gallicchio/op-amp-pcb/design_reviews/2026-10-24_Claude-Fable-5.1/z_sw1.png

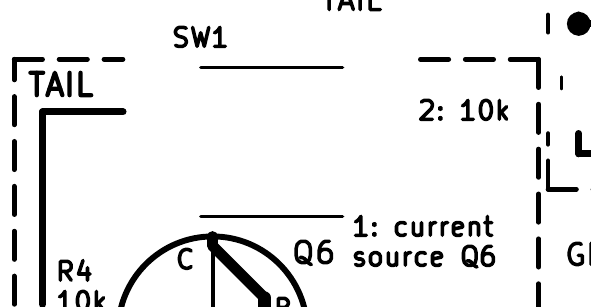
design_reviews/2026-10-24_Claude-Fable-5.1/z_sw1.png
