gallicchio/op-amp-pcb/design_reviews/2026-10-27_KimiK3/bcu-1.png

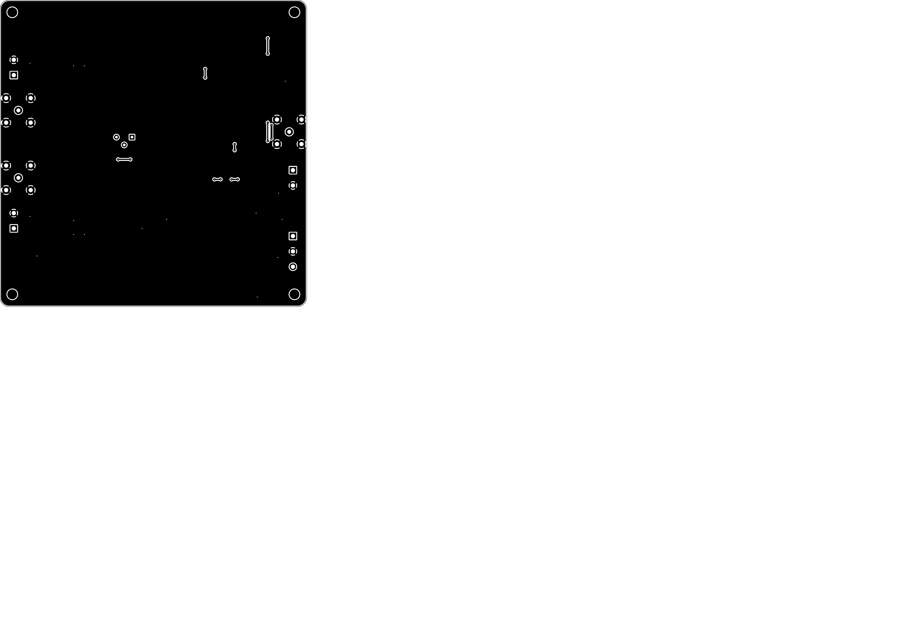
design_reviews/2026-10-27_KimiK3/bcu-1.png
