gallicchio/op-amp-pcb/design_reviews/2026-10-27_KimiK3/crop_d1d2.png

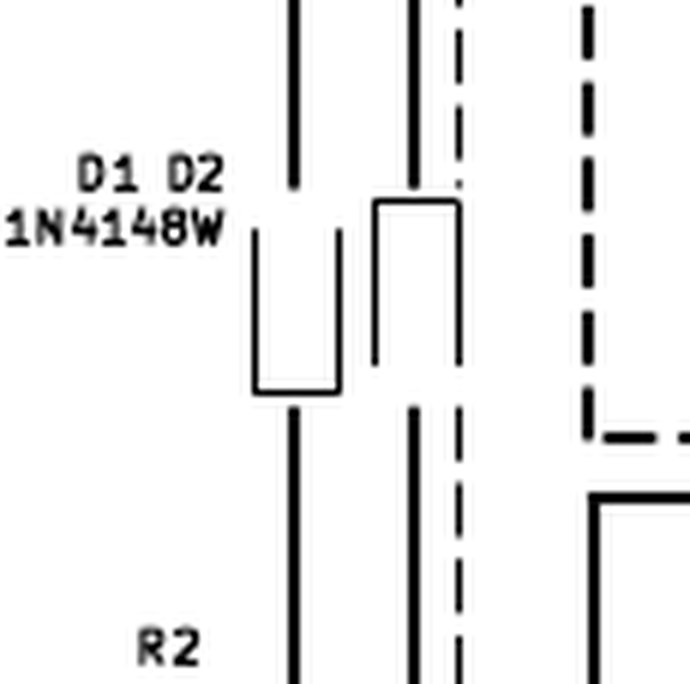
design_reviews/2026-10-27_KimiK3/crop_d1d2.png
