gallicchio/op-amp-pcb/design_reviews/2026-10-27_KimiK3/crop_d5d6.png

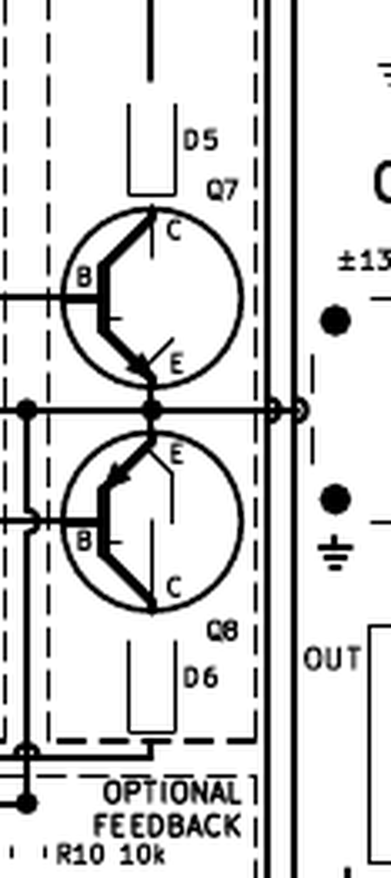
design_reviews/2026-10-27_KimiK3/crop_d5d6.png
