gallicchio/op-amp-pcb/design_reviews/2026-10-27_KimiK3/z_d5d6_big.png

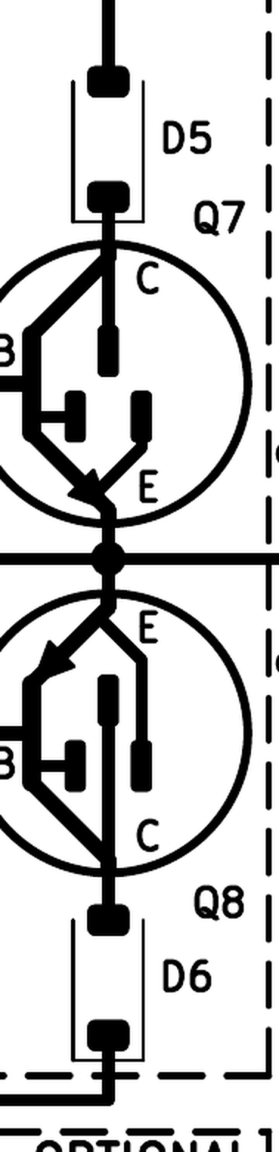
design_reviews/2026-10-27_KimiK3/z_d5d6_big.png
