gallicchio/op-amp-pcb/design_reviews/2026-10-27_KimiK3/z_gain_comp.png

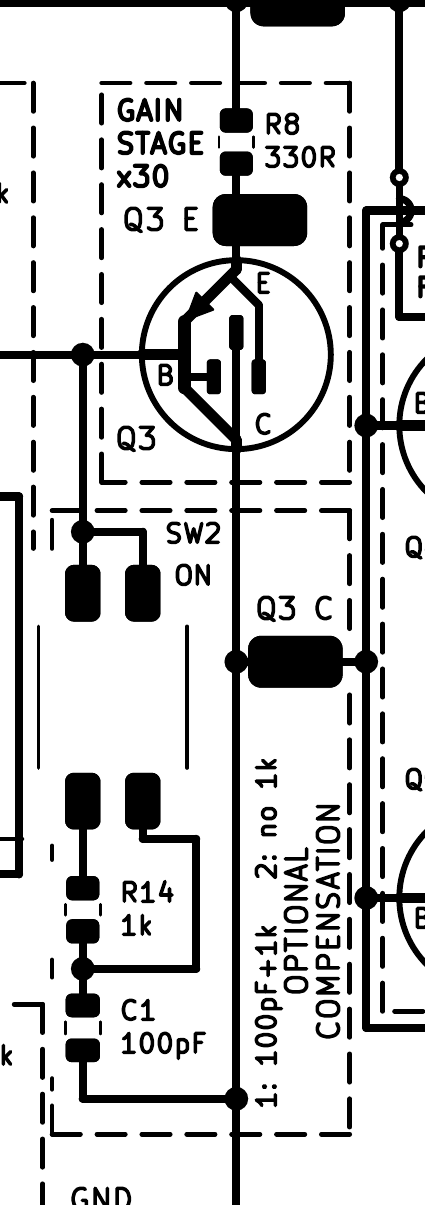
design_reviews/2026-10-27_KimiK3/z_gain_comp.png
