gallicchio/op-amp-pcb/docs/images/opamp-bottom.png

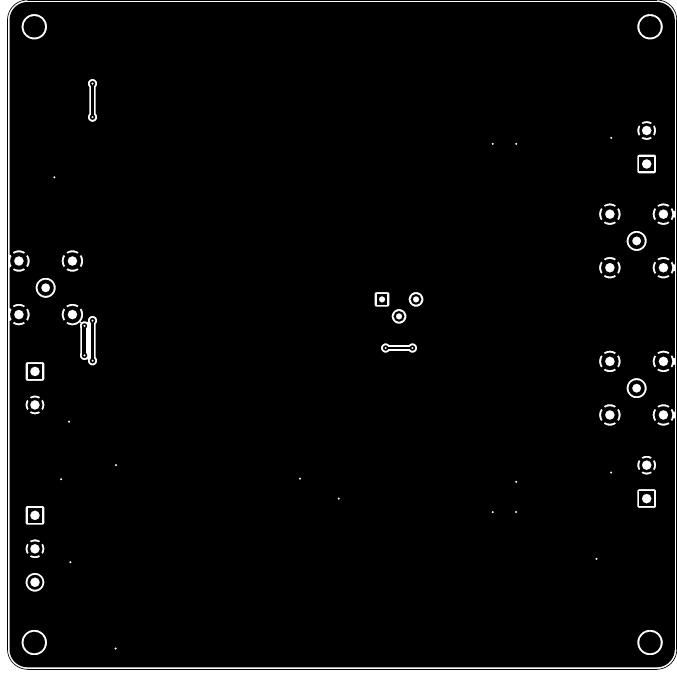
docs/images/opamp-bottom.png
