gallicchio/op-amp-pcb/docs/images/opamp-render-bottom.png

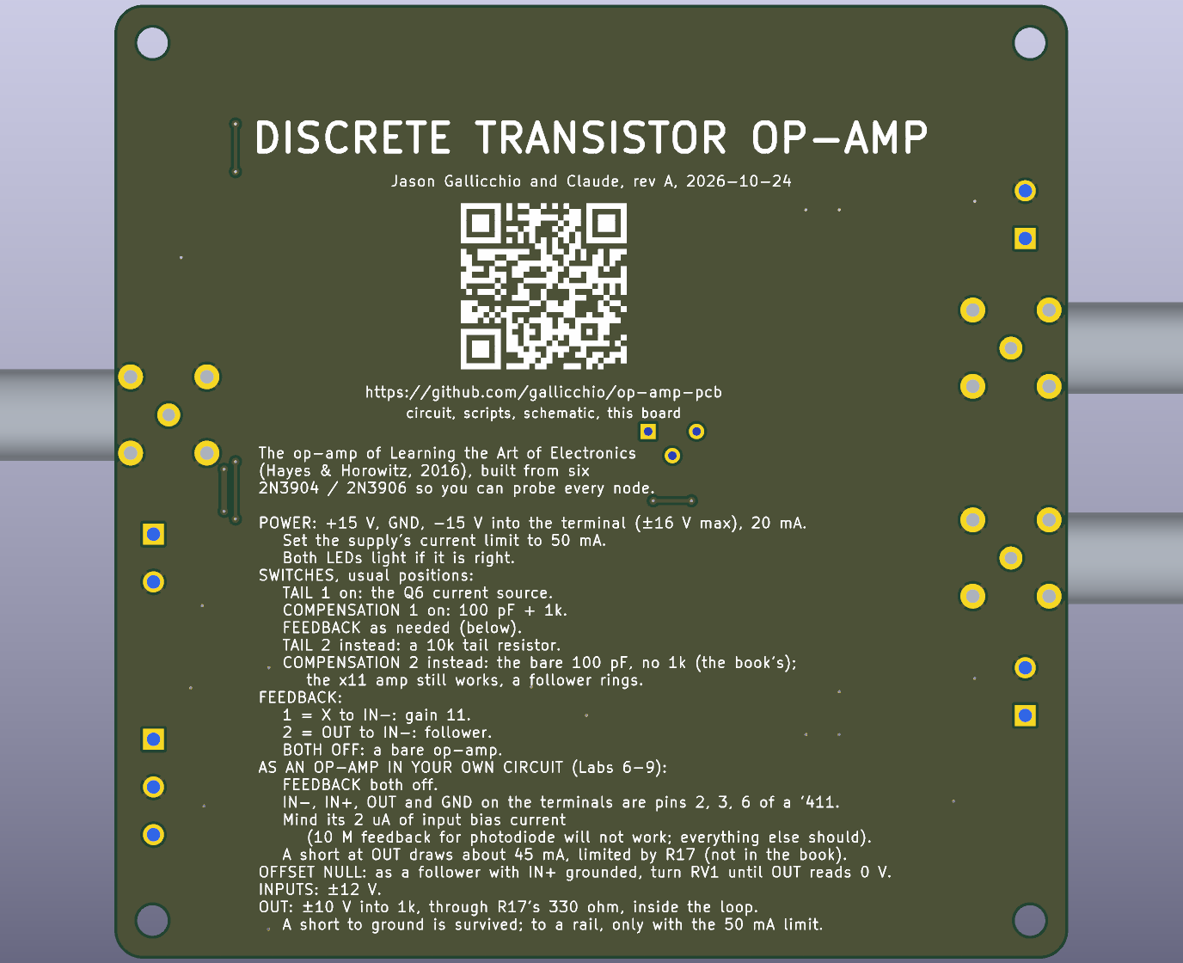
docs/images/opamp-render-bottom.png
