gallicchio/op-amp-pcb/docs/images/opamp-render-top.png

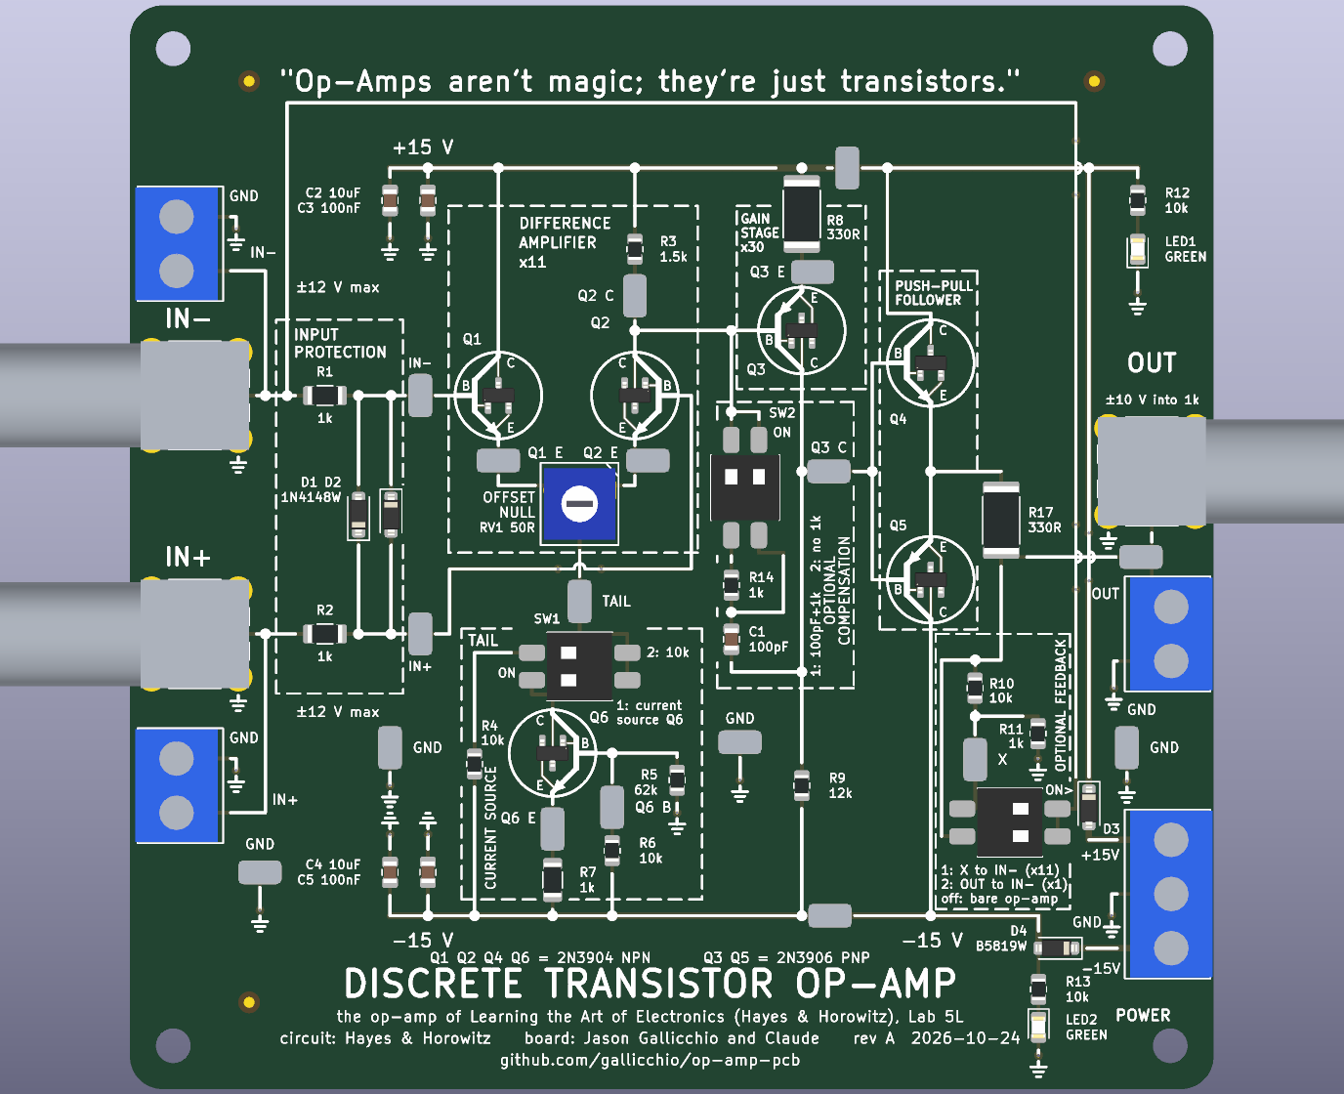
docs/images/opamp-render-top.png
