gallicchio/op-amp-pcb/docs/images/opamp-silk-top.png

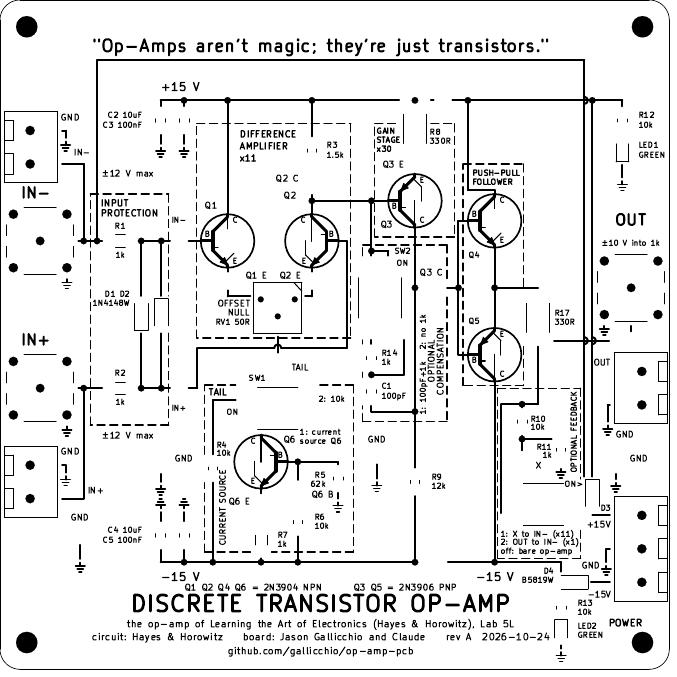
docs/images/opamp-silk-top.png
