gallicchio/op-amp-pcb/out/opamp/opamp_bom_costed.csv

Comment | Designator | Footprint | LCSC Part # | MPN | Qty | Unit $ | Ext $ | JLC
100pF | C1 | C_0805_2012Metric | C1790 | CL21C101JBANNNC | 1 | 0.0101 | 0.010 | basic
10uF | C2,C4 | C_0805_2012Metric | C15850 | CL21A106KAYNNNE | 2 | 0.0426 | 0.085 | basic
100nF | C3,C5 | C_0805_2012Metric | C49678 | CC0805KRX7R9BB104 | 2 | 0.0205 | 0.041 | basic
1N4148W | D1,D2 | D_SOD-123 | C81598 | 1N4148W | 2 | 0.0124 | 0.025 | basic
B5819W | D3,D4 | D_SOD-123 | C8598 | B5819W SL | 2 | 0.0260 | 0.052 | basic
IN- / GND | J4 | TerminalBlock_KF301_1x02_P5.00mm | C474881 | KF301-5.0-2P | 1 | 0.1020 | 0.102 | extended
IN+ / GND | J5 | TerminalBlock_KF301_1x02_P5.00mm | C474881 | KF301-5.0-2P | 1 | 0.1020 | 0.102 | extended
+15 / GND / -15 | J6 | TerminalBlock_KF301_1x03_P5.00mm | C474882 | KF301-5.0-3P | 1 | 0.1400 | 0.140 | extended
OUT / GND | J7 | TerminalBlock_KF301_1x02_P5.00mm | C474881 | KF301-5.0-2P | 1 | 0.1020 | 0.102 | extended
BNC | J1,J2,J3 | BNC_KYWE_RightAngle | C41416668 | BNC-KYWE-295-W4-N | 3 | 1.2930 | 3.879 | extended
GREEN | LED1,LED2 | LED_0805_2012Metric | C2297 | KT-0805G | 2 | 0.0164 | 0.033 | basic
2N3906 | Q3,Q5 | SOT-23 | C53444 | MMBT3906LT1G | 2 | 0.0190 | 0.038 | extended
2N3904 | Q1,Q2,Q4,Q6 | SOT-23 | C20526 | MMBT3904 | 4 | 0.0116 | 0.046 | basic
1.5k | R3 | R_0805_2012Metric | C4310 | 0805W8F1501T5E | 1 | 0.0028 | 0.003 | basic
62k | R5 | R_0805_2012Metric | C17783 | 0805W8F6202T5E | 1 | 0.0021 | 0.002 | preferred
12k | R9 | R_0805_2012Metric | C17444 | 0805W8F1202T5E | 1 | 0.0028 | 0.003 | basic
50R | RV1 | Potentiometer_Bourns_3362P_Vertical | C52754333 | 3362P-1-500 | 1 | 0.3370 | 0.337 | extended
330R | R8,R17 | R_2512_6332Metric | C2934068 | FRC2512F3300TS | 2 | 0.0348 | 0.070 | extended
1k | R11,R14 | R_0805_2012Metric | C17513 | 0805W8F1001T5E | 2 | 0.0035 | 0.007 | basic
1k | R1,R2,R7 | R_1206_3216Metric | C4410 | 1206W4F1001T5E | 3 | 0.0085 | 0.026 | basic
10k | R4,R6,R10,R12,R13 | R_0805_2012Metric | C17414 | 0805W8F1002T5E | 5 | 0.0034 | 0.017 | basic
TAIL | SW1 | SW_DIP_SPSTx02_KingTek_DSIC02_P2.54mm | C54949 | DSIC02LSGET | 1 | 0.3080 | 0.308 | extended
COMPENSATION | SW2 | SW_DIP_SPSTx02_KingTek_DSIC02_P2.54mm | C54949 | DSIC02LSGET | 1 | 0.3080 | 0.308 | extended
FEEDBACK | SW3 | SW_DIP_SPSTx02_KingTek_DSIC02_P2.54mm | C54949 | DSIC02LSGET | 1 | 0.3080 | 0.308 | extended
IN- | TP1 | TestPoint_Loop_RH-5019 | C5199800 | RH-5019 | 1 | 0.0966 | 0.097 | extended
IN+ | TP2 | TestPoint_Loop_RH-5019 | C5199800 | RH-5019 | 1 | 0.0966 | 0.097 | extended
TAIL | TP3 | TestPoint_Loop_RH-5019 | C5199800 | RH-5019 | 1 | 0.0966 | 0.097 | extended
Q6 E | TP4 | TestPoint_Loop_RH-5019 | C5199800 | RH-5019 | 1 | 0.0966 | 0.097 | extended
Q6 B | TP5 | TestPoint_Loop_RH-5019 | C5199800 | RH-5019 | 1 | 0.0966 | 0.097 | extended
Q2 C | TP6 | TestPoint_Loop_RH-5019 | C5199800 | RH-5019 | 1 | 0.0966 | 0.097 | extended
Q3 E | TP7 | TestPoint_Loop_RH-5019 | C5199800 | RH-5019 | 1 | 0.0966 | 0.097 | extended
Q3 C | TP8 | TestPoint_Loop_RH-5019 | C5199800 | RH-5019 | 1 | 0.0966 | 0.097 | extended
OUT | TP9 | TestPoint_Loop_RH-5019 | C5199800 | RH-5019 | 1 | 0.0966 | 0.097 | extended
X | TP10 | TestPoint_Loop_RH-5019 | C5199800 | RH-5019 | 1 | 0.0966 | 0.097 | extended
+15V | TP11 | TestPoint_Loop_RH-5019 | C5199800 | RH-5019 | 1 | 0.0966 | 0.097 | extended
-15V | TP12 | TestPoint_Loop_RH-5019 | C5199800 | RH-5019 | 1 | 0.0966 | 0.097 | extended
Q1 E | TP13 | TestPoint_Loop_RH-5019 | C5199800 | RH-5019 | 1 | 0.0966 | 0.097 | extended
Q2 E | TP14 | TestPoint_Loop_RH-5019 | C5199800 | RH-5019 | 1 | 0.0966 | 0.097 | extended
GND | TP100,TP101,TP102,TP103 | TestPoint_Loop_RH-5019 | C5199800 | RH-5019 | 4 | 0.0966 | 0.386 | extended
