gallicchio/op-amp-pcb/out/opamp/opamp-assembly-notes.txt

DISCRETE TRANSISTOR OP-AMP -- notes for the assembler
=====================================================

PLACEMENTS
  Use opamp_cpl_jlcpcb_upload.csv for JLCPCB.  It is opamp_cpl_kicad_native.csv
  with JLCPCB's own per-part rotations applied; use the native file anywhere else.

Q1-Q8 -- SOT-23 transistors, 1 = B, 2 = E, 3 = C.  Each sits inside a silkscreen
  circle; the two bottom pads (or, for Q2 and Q6, the two top pads) are base and
  emitter, the single pad on the other side is the collector.

SW1, SW2, SW3 -- 2-way DIP switches.  Any orientation that puts the pads on the
  pads is electrically right; the part's own ON marking goes on the side of
  the silkscreen word ON beside each switch (left of SW1, above SW2; the 'ON>' above SW3's right-hand pads points at it).

RV1 -- 3362P trimmer, keyed by its three holes: it fits one way only.

J1, J2, J3 -- BNC jacks.  The barrel points OFF the board edge: J1 and J2 off the
  left-hand edge, J3 off the right-hand edge.

J4, J5, J6, J7 -- screw terminal blocks.  The wire openings face the board edge.

D1-D6, LED1, LED2 -- polarised; the cathode is pad 1, at the end the silkscreen
  bar marks.
