gallicchio/op-amp-pcb/out/opamp/opamp-fabrication-notes.txt

Discrete Transistor Op-Amp rev A (2026-10-24) -- JLCPCB order form, field by field
==============================================================================

[PCB]
  Base Material                FR-4      (the default)
  Layers                       2      (what the gerber set contains)
  Dimensions                   100 x 100 mm      (read from the board outline; the discounted size)
  PCB Qty                      5      (the minimum; 10 costs about three dollars more)
  Product Type                 Industrial/Consumer electronics      (the default)
[PCB Specifications]
  Different Design             1      (one board in the outline)
  Delivery Format              Single PCB      (no panel)
  PCB Thickness                1.6 mm      (the BNC flanges and the terminal blocks expect it)
  PCB Color                    Green      (any; the white silkscreen reads best on green or black)
  Silkscreen                   White      (the default for green)
  Material Type                FR4-Standard TG 135-140      (the default; nothing here gets warm)
  Surface Finish               LeadFree HASL      (students handle this board: lead-free.  ENIG is fine too)
[High-spec Options]
  Outer Copper Weight          1 oz      (the design rules assume it)
  Via Covering                 Tented      (or Plugged if the form upgrades it: either is fine, no via must stay open)
  Min via hole size/diameter   0.3 mm / (0.4 / 0.45 mm)      (the smallest via on the board is 0.30 mm drill, 0.80 mm pad)
  Board Outline Tolerance      +/-0.2 mm (Regular)      (nothing mates with the edge)
  Confirm Production file      No      (the gerbers are checked here)
  Mark on PCB                  Remove Mark      (the whole front is a drawing; nowhere for an order number)
  Electrical Test              Flying Probe Fully Test      (the default)
  Gold Fingers                 No
  Castellated Holes            No
  Edge Plating                 No
[PCB Assembly]
  PCBA Type                    Economic      (all parts on one side, nothing fine-pitch)
  Assembly Side                Top      (every part is on the front)
  PCBA Qty                     2, or as many as the class needs      (the per-order fees are the same for 2 or 20)
  Edge Rails/Fiducials         Added by JLCPCB      (the board has three 1 mm fiducials in its corners; let them add rails anyway, removed before delivery)
  Confirm Parts Placement      Yes      (look at the preview against PLACEMENT_CHECKS.txt before paying)
  Parts Selection              By JLCPCB      (every BOM line has an LCSC code)
  Through-hole parts           keep them: J1, J2, J3, J4, J5, J6, J7, RV1      (the form lists them separately; the BNCs, terminals and trimmer are meant to be fitted)
  Bake Components              No      (nothing moisture-sensitive)
  Stencil                      none      (JLCPCB keeps its own; nothing to order)

Upload:
  gerbers     out/opamp/opamp-gerbers.zip
  BOM         out/opamp/opamp_bom_jlcpcb_upload.csv
  CPL         out/opamp/opamp_cpl_jlcpcb_upload.csv   (JLCPCB only; others take _kicad_native)
  remark      paste out/opamp/opamp-assembly-notes.txt

Then read PLACEMENT_CHECKS.txt against the preview, front and (empty) back.
