gallicchio/op-amp-pcb/docs/history/2026-10-24-r3-feedback-power.png

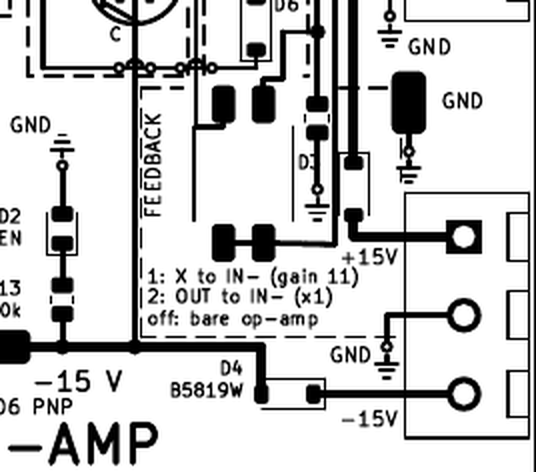
docs/history/2026-10-24-r3-feedback-power.png
