gallicchio/op-amp-pcb/out/opamp/opamp-assembly-top.pdf

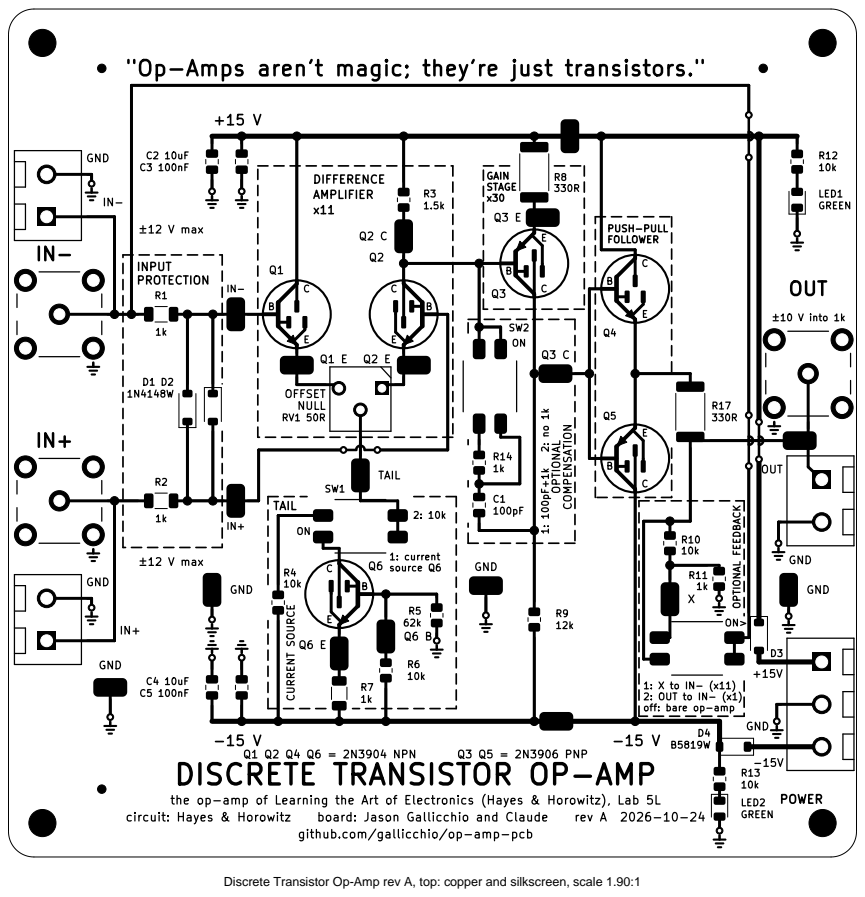
[picture p87: page 1]

"Op-Amps aren't magic; they're just transistors."

2: OUT to IN- (x1)
off: bare op-amp

DISCRETE TRANSISTOR OP-AMP

the op-amp of Learning the Art of Electronics (Hayes & Horowitz), Lab 5L

github.com/gallicchio/op-amp-pcb

Discrete Transistor Op-Amp rev A, top: copper and silkscreen, scale 1.90:1
