gallicchio/op-amp-pcb/out/opamp/opamp-schematic.pdf

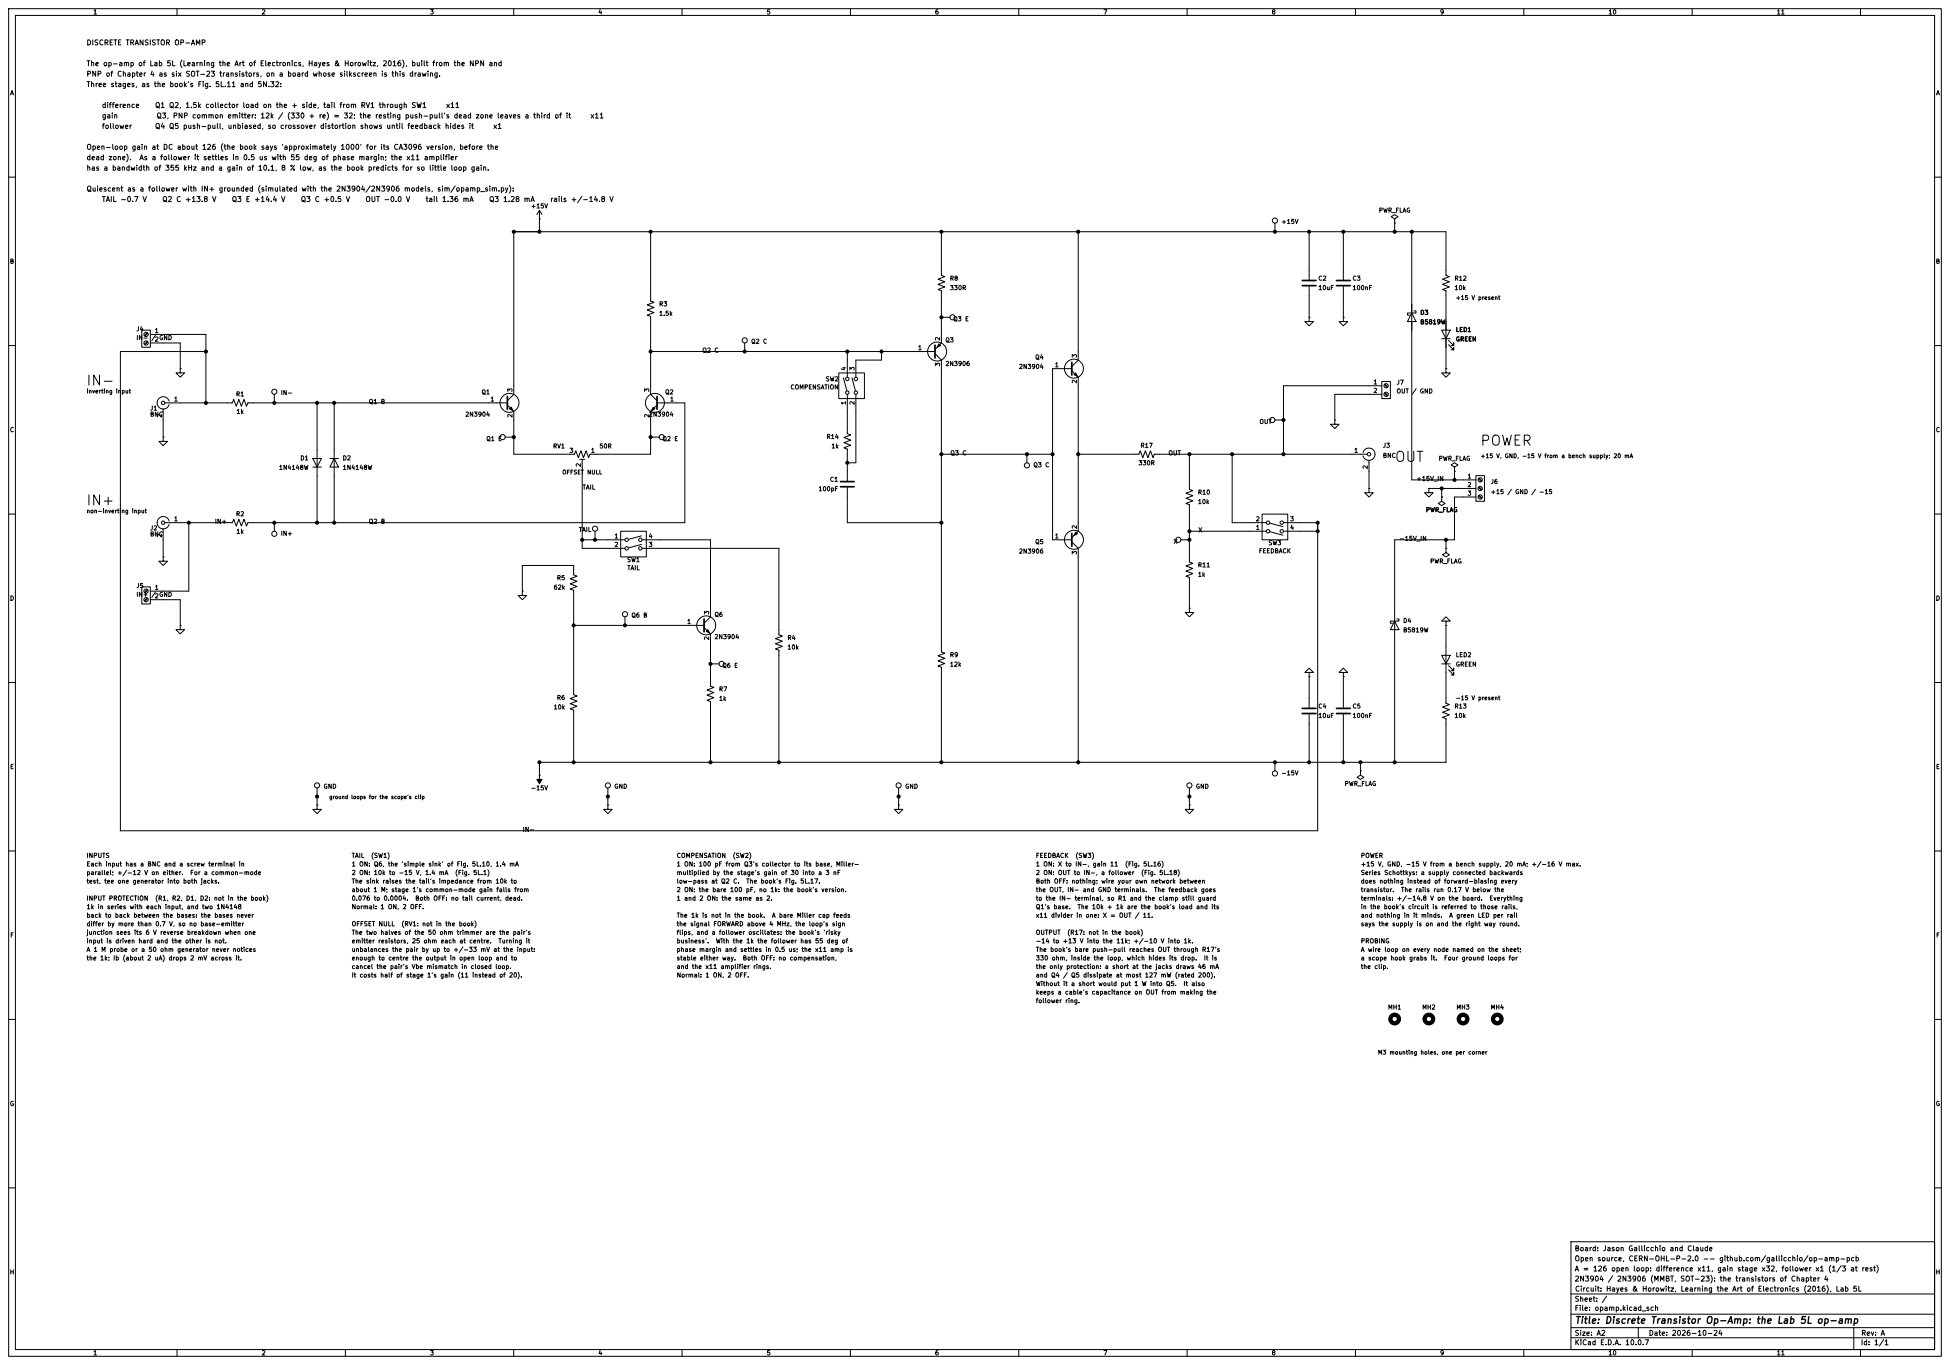
[picture p88: page 1]

DISCRETE TRANSISTOR OP-AMP

The op-amp of Lab 5L (Learning the Art of Electronics, Hayes & Horowitz, 2016), built from the NPN and
PNP of Chapter 4 as six SOT-23 transistors, on a board whose silkscreen is this drawing.
Three stages, as the book's Fig. 5L.11 and 5N.32:

Open-loop gain at DC about 126 (the book says 'approximately 1000' for its CA3096 version, before the
dead zone). As a follower it settles in 0.5 us with 55 deg of phase margin; the x11 amplifier
has a bandwidth of 355 kHz and a gain of 10.1, 8 % low, as the book predicts for so little loop gain.

Quiescent as a follower with IN+ grounded (simulated with the 2N3904/2N3906 models, sim/opamp_sim.py):

ground loops for the scope's clip

test, tee one generator into both jacks. 1k in series with each input, and two 1N4148

the only protection: a short at the jacks draws 46 mA 1 ON: 100 pF from Q3's collector to its base, Miller-

does nothing instead of forward-biasing every

to the IN- terminal, so R1 and the clamp still guard

junction sees its 6 V reverse breakdown when one

the signal FORWARD above 4 MHz, the loop's sign
flips, and a follower oscillates: the book's 'risky

the 1k; Ib (about 2 uA) drops 2 mV across it.

enough to centre the output in open loop and to

and Q4 / Q5 dissipate at most 127 mW (rated 200).

Board: Jason Gallicchio and Claude
Open source, CERN-OHL-P-2.0 -- github.com/gallicchio/op-amp-pcb
A = 126 open loop: difference x11, gain stage x32, follower x1 (1/3 at rest)
2N3904 / 2N3906 (MMBT, SOT-23): the transistors of Chapter 4
Circuit: Hayes & Horowitz, Learning the Art of Electronics (2016), Lab 5L
Sheet: /
File: opamp.kicad_sch
Title: Discrete Transistor Op-Amp: the Lab 5L op-amp

Size: A2 | Rev: A
KiCad E.D.A. 10.0.7 | Id: 1/1
