gallicchio/op-amp-pcb/design_reviews/2026-10-27_KimiK3/bcu.pdf

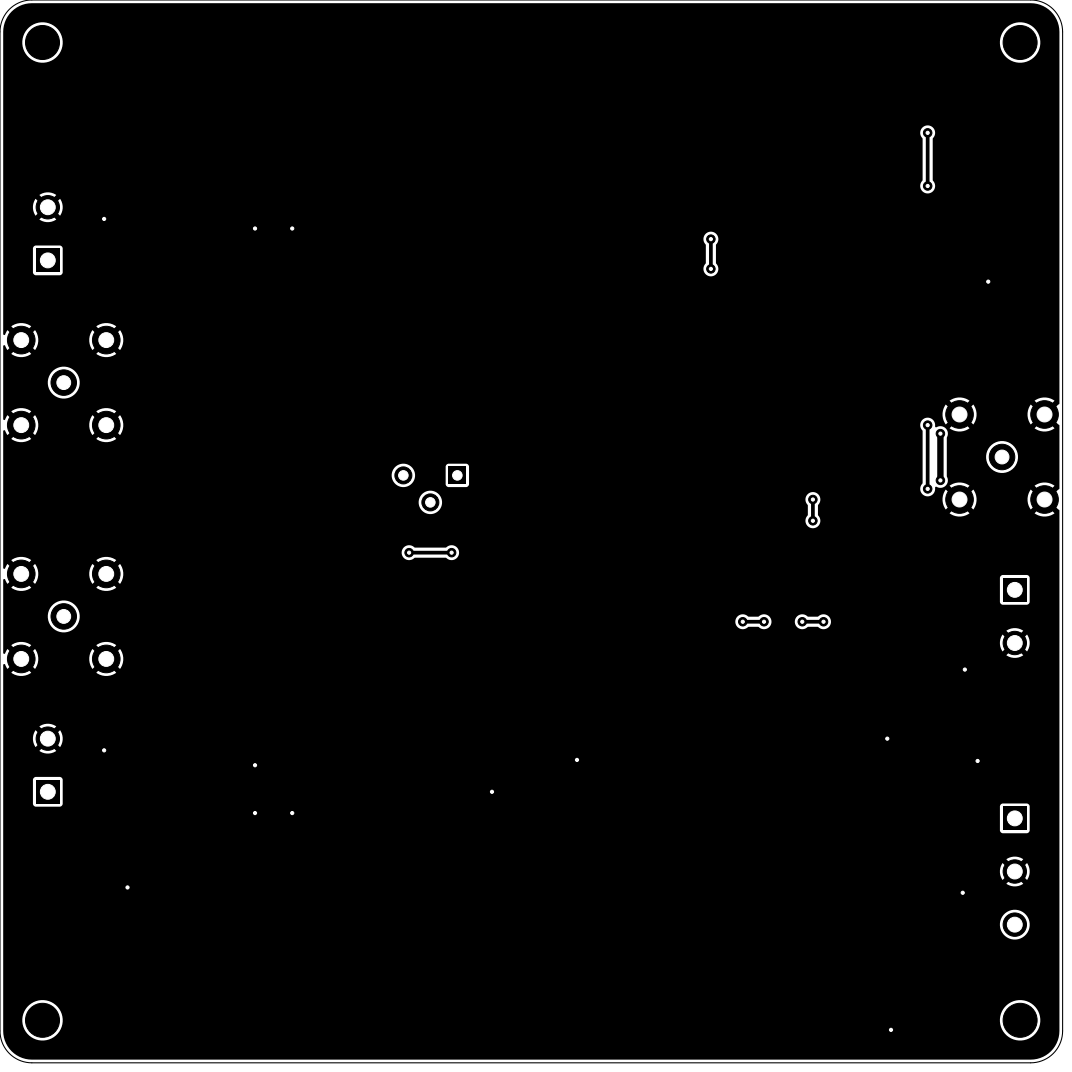
[picture p89: page 1]
