gallicchio/op-amp-pcb/design_reviews/2026-10-27_KimiK3/silk_cu.pdf

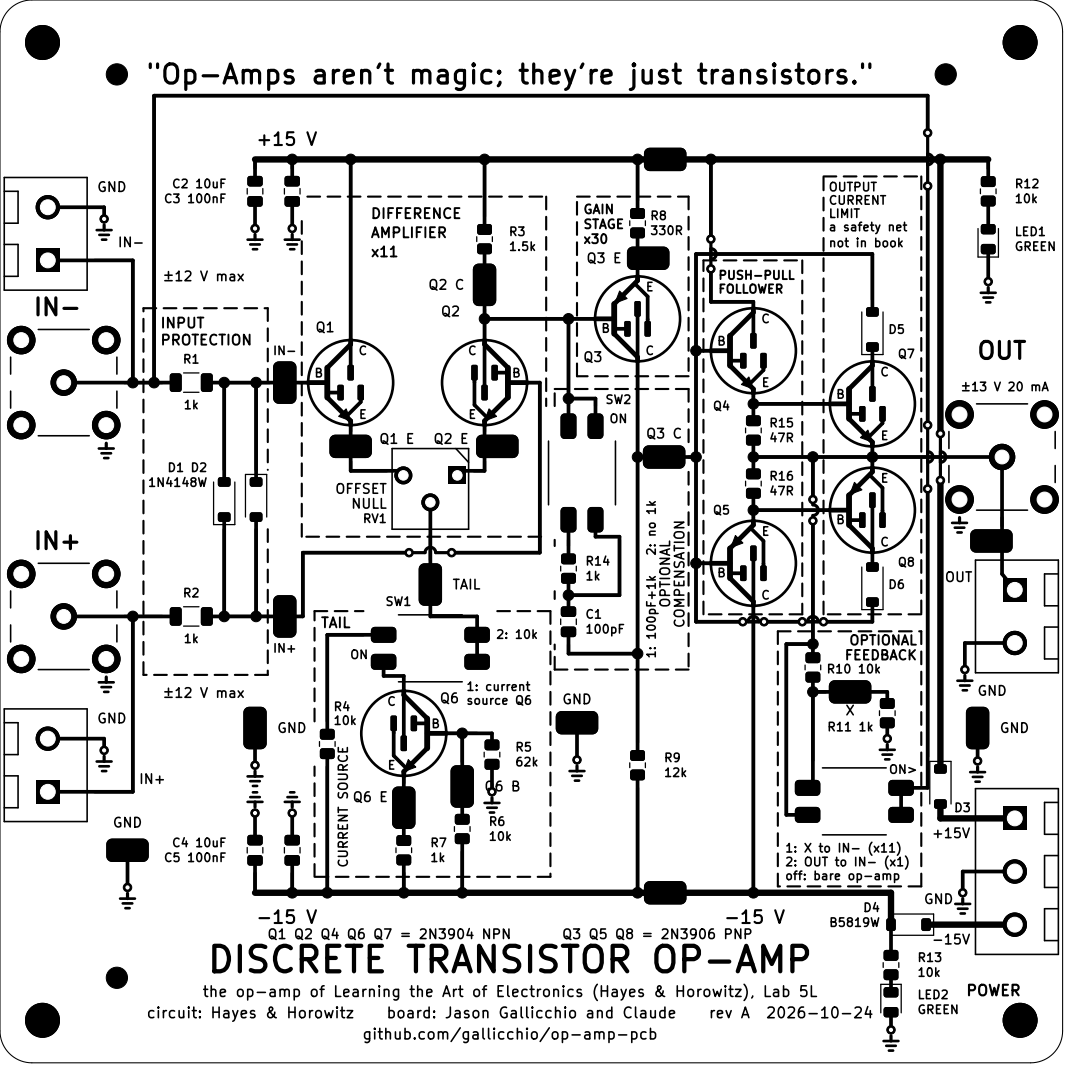
[picture p90: page 1]

"Op-Amps aren't magic; they're just transistors."

DISCRETE TRANSISTOR OP-AMP
