gallicchio/op-amp-pcb/hardware/opamp.kicad_pcb

## KiCad design hardware/opamp.kicad_pcb (2026-10-28)

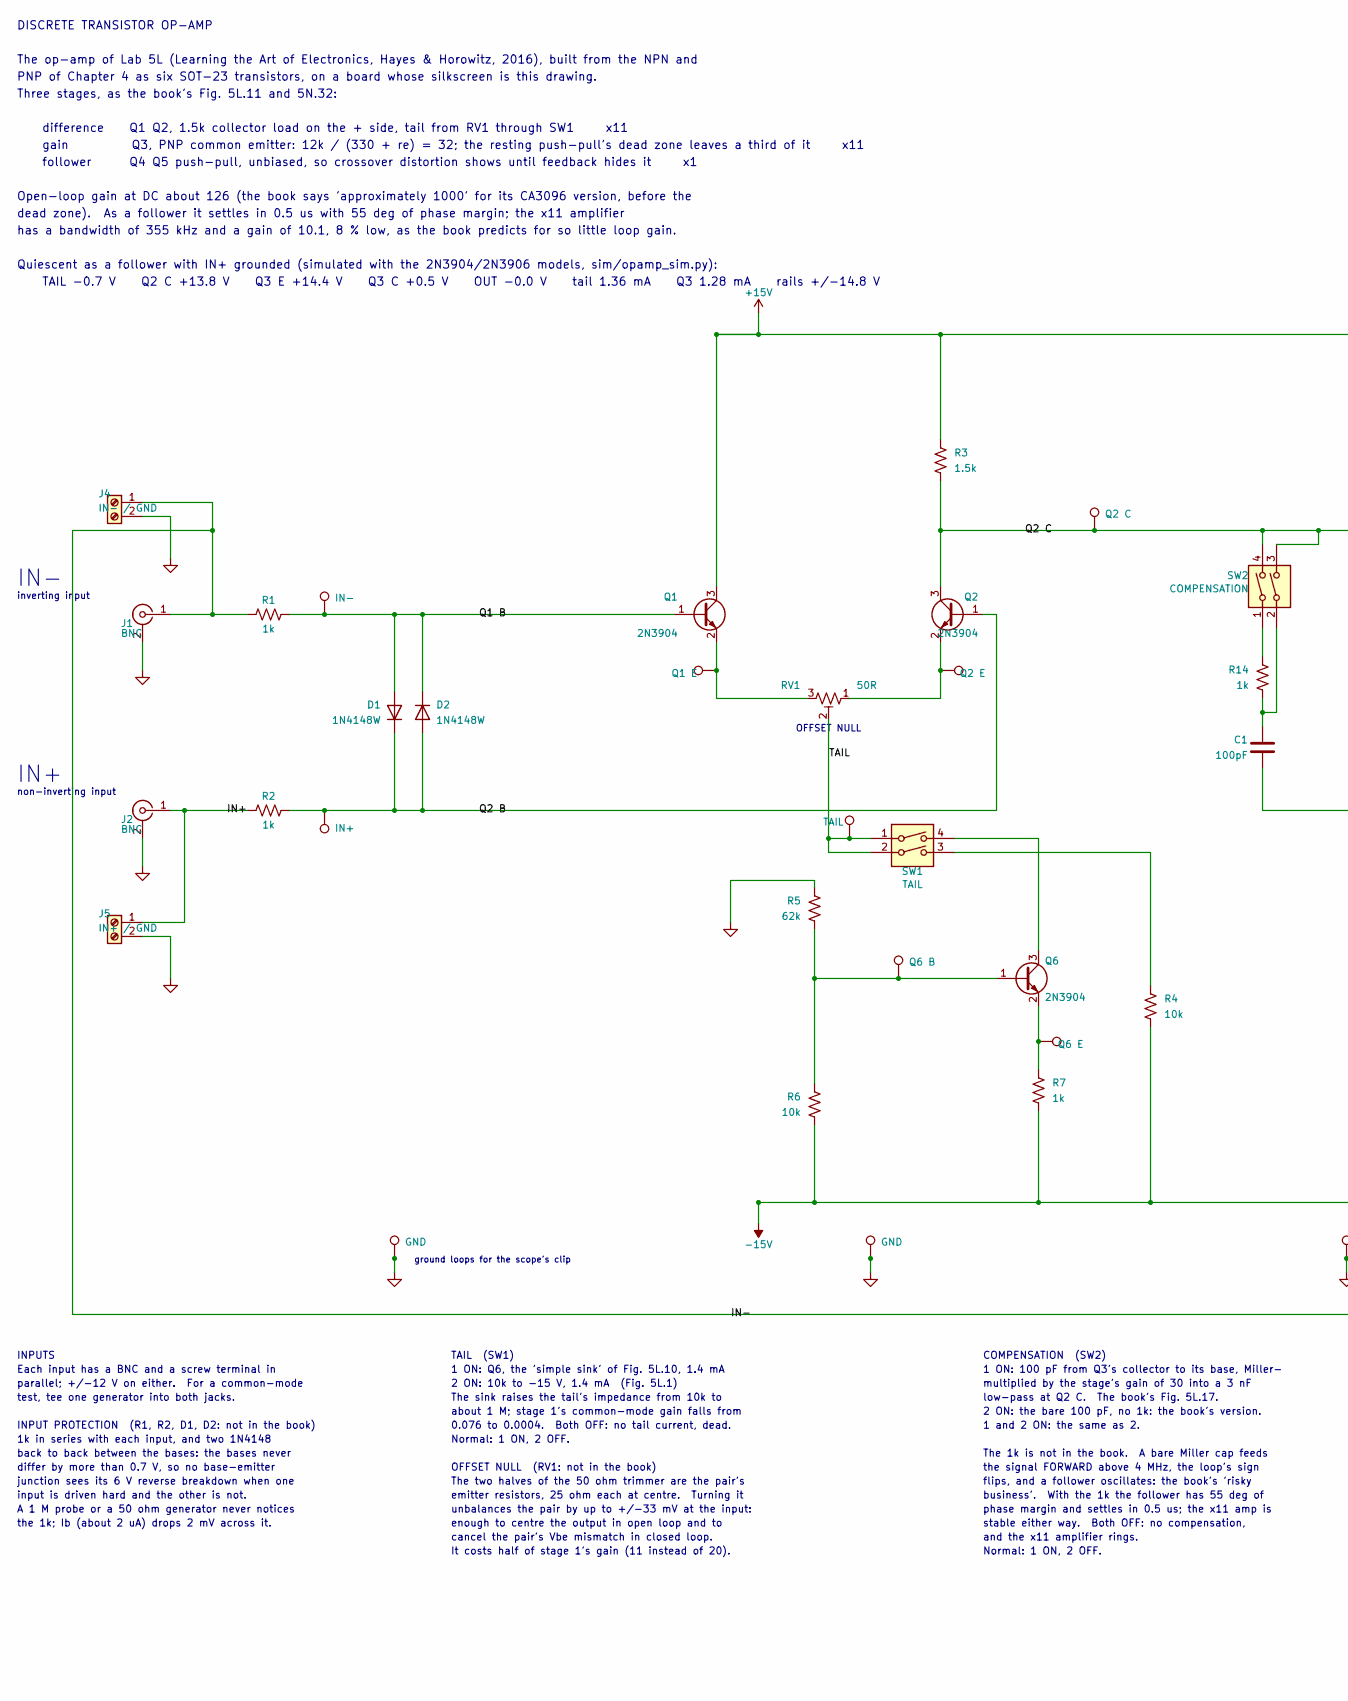
[picture p91: schematic opamp.kicad_sch, Discrete Transistor Op-Amp: the Lab 5L op-amp of Learning t…, part in row 1, column 1]

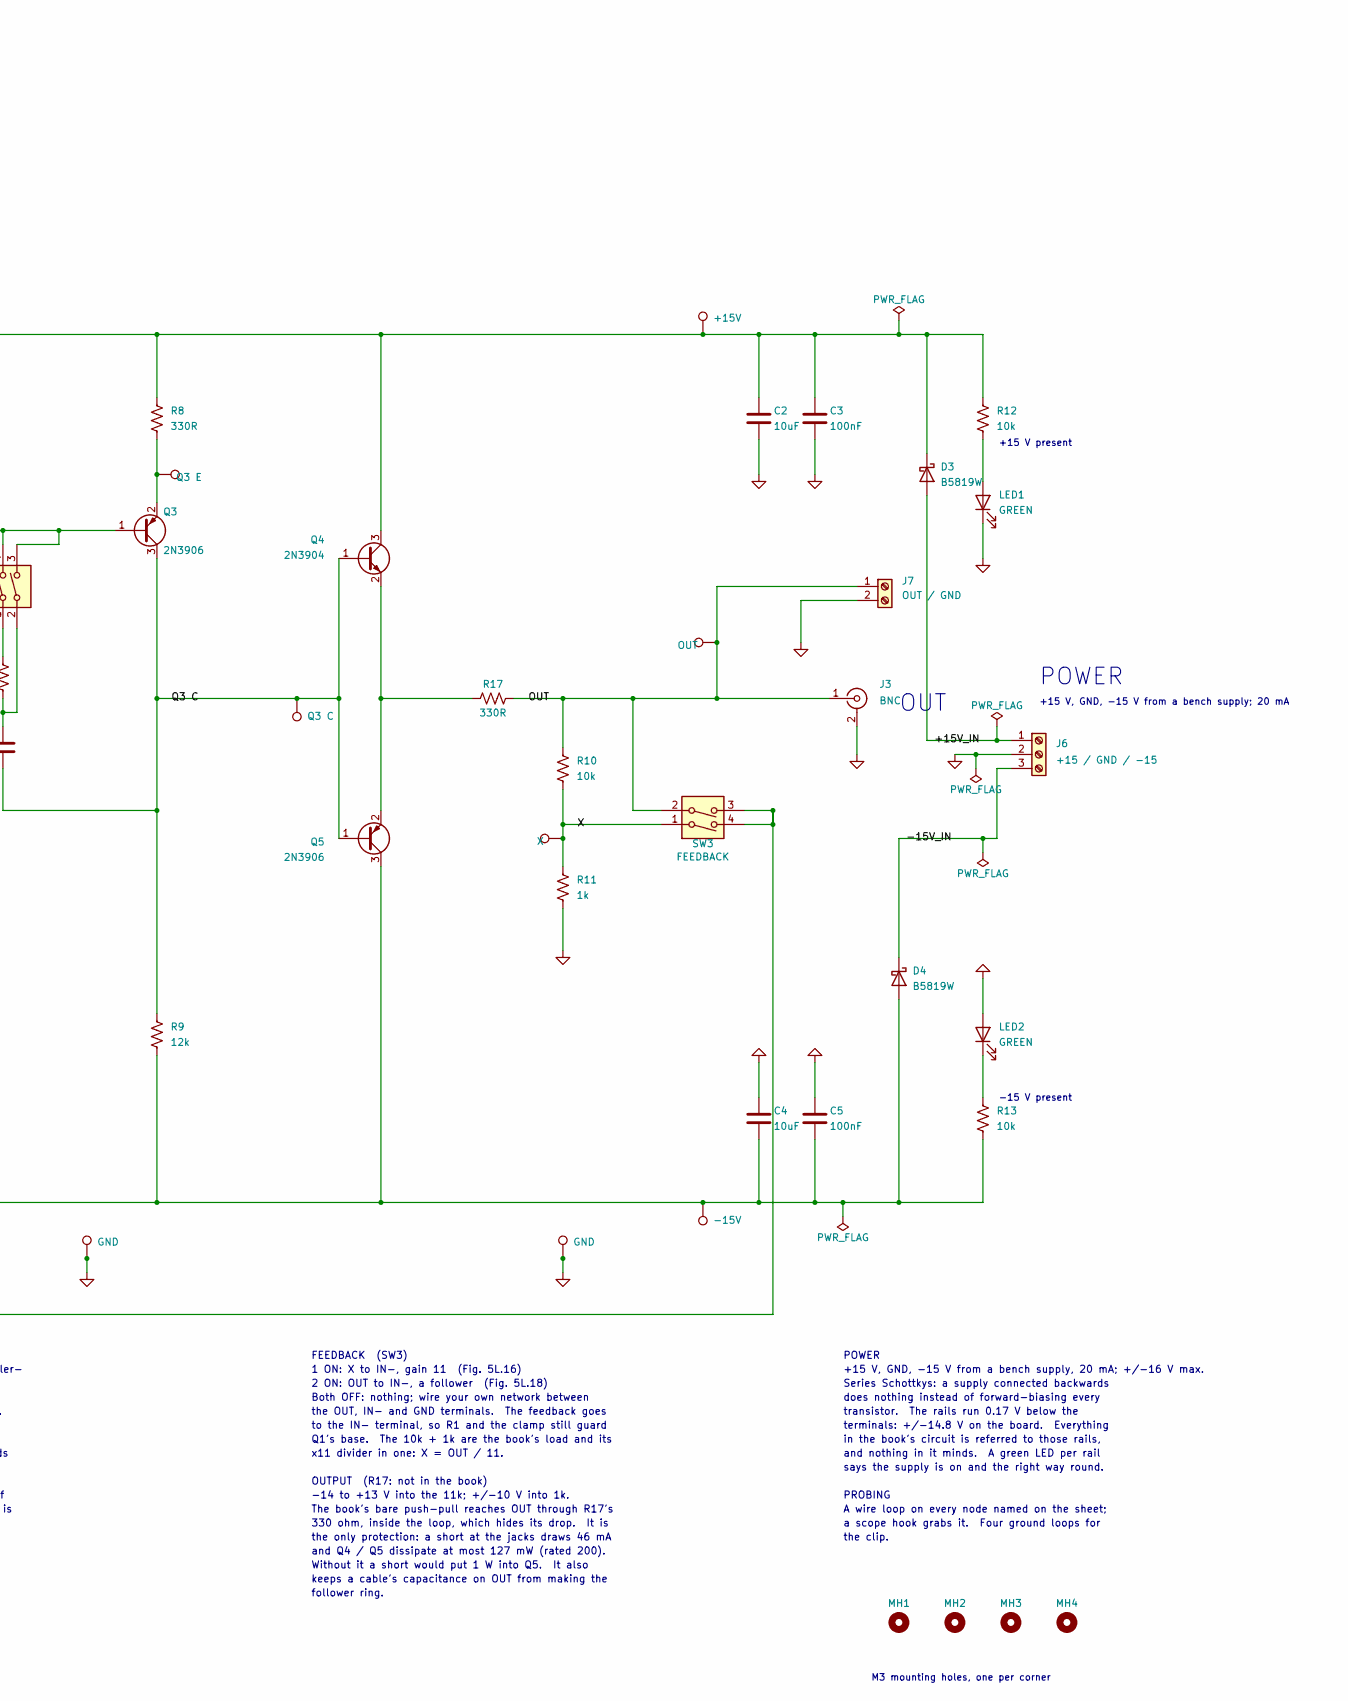
[picture p92: schematic opamp.kicad_sch, Discrete Transistor Op-Amp: the Lab 5L op-amp of Learning t…, part in row 1, column 2]

Parts:
C1: 100pF; C_0805_2012Metric; MPN CL21C101JBANNNC; LCSC C1790
C2, C4: 10uF; C_0805_2012Metric; MPN CL21A106KAYNNNE; LCSC C15850
C3, C5: 100nF; C_0805_2012Metric; MPN CC0805KRX7R9BB104; LCSC C49678
D1, D2: 1N4148W; D_SOD-123; MPN 1N4148W; LCSC C81598
D3, D4: B5819W; D_SOD-123; MPN B5819W SL; LCSC C8598
J1, J2, J3: BNC; BNC_KYWE_RightAngle; MPN BNC-KYWE-295-W4-N; LCSC C41416668
J4: IN- / GND; TerminalBlock_KF301_1x02_P5.00mm; MPN KF301-5.0-2P; LCSC C474881
J5: IN+ / GND; TerminalBlock_KF301_1x02_P5.00mm; MPN KF301-5.0-2P; LCSC C474881
J6: +15 / GND / -15; TerminalBlock_KF301_1x03_P5.00mm; MPN KF301-5.0-3P; LCSC C474882
J7: OUT / GND; TerminalBlock_KF301_1x02_P5.00mm; MPN KF301-5.0-2P; LCSC C474881
LED1, LED2: GREEN; LED_0805_2012Metric; MPN KT-0805G; LCSC C2297
MH1, MH2, MH3, MH4: MountingHole; MountingHole_3.2mm_M3
Q1, Q2, Q4, Q6: 2N3904; SOT-23; MPN MMBT3904; LCSC C20526
Q3, Q5: 2N3906; SOT-23; MPN MMBT3906LT1G; LCSC C53444
R1, R2, R7: 1k; R_1206_3216Metric; MPN 1206W4F1001T5E; LCSC C4410
R3: 1.5k; R_0805_2012Metric; MPN 0805W8F1501T5E; LCSC C4310
R4, R6, R10, R12, R13: 10k; R_0805_2012Metric; MPN 0805W8F1002T5E; LCSC C17414
R5: 62k; R_0805_2012Metric; MPN 0805W8F6202T5E; LCSC C17783
R8, R17: 330R; R_2512_6332Metric; MPN FRC2512F3300TS; LCSC C2934068
R9: 12k; R_0805_2012Metric; MPN 0805W8F1202T5E; LCSC C17444
R11, R14: 1k; R_0805_2012Metric; MPN 0805W8F1001T5E; LCSC C17513
RV1: 50R; Potentiometer_Bourns_3362P_Vertical; MPN 3362P-1-500; LCSC C52754333
SW1: TAIL; SW_DIP_SPSTx02_KingTek_DSIC02_P2.54mm; MPN DSIC02LSGET; LCSC C54949
SW2: COMPENSATION; SW_DIP_SPSTx02_KingTek_DSIC02_P2.54mm; MPN DSIC02LSGET; LCSC C54949
SW3: FEEDBACK; SW_DIP_SPSTx02_KingTek_DSIC02_P2.54mm; MPN DSIC02LSGET; LCSC C54949
TP1: IN-; TestPoint_Loop_RH-5019; MPN RH-5019; LCSC C5199800
TP2: IN+; TestPoint_Loop_RH-5019; MPN RH-5019; LCSC C5199800
TP3: TAIL; TestPoint_Loop_RH-5019; MPN RH-5019; LCSC C5199800
TP4: Q6 E; TestPoint_Loop_RH-5019; MPN RH-5019; LCSC C5199800
TP5: Q6 B; TestPoint_Loop_RH-5019; MPN RH-5019; LCSC C5199800
TP6: Q2 C; TestPoint_Loop_RH-5019; MPN RH-5019; LCSC C5199800
TP7: Q3 E; TestPoint_Loop_RH-5019; MPN RH-5019; LCSC C5199800
TP8: Q3 C; TestPoint_Loop_RH-5019; MPN RH-5019; LCSC C5199800
TP9: OUT; TestPoint_Loop_RH-5019; MPN RH-5019; LCSC C5199800
TP10: X; TestPoint_Loop_RH-5019; MPN RH-5019; LCSC C5199800
TP11: +15V; TestPoint_Loop_RH-5019; MPN RH-5019; LCSC C5199800
TP12: -15V; TestPoint_Loop_RH-5019; MPN RH-5019; LCSC C5199800
TP13: Q1 E; TestPoint_Loop_RH-5019; MPN RH-5019; LCSC C5199800
TP14: Q2 E; TestPoint_Loop_RH-5019; MPN RH-5019; LCSC C5199800
TP100, TP101, TP102, TP103: GND; TestPoint_Loop_RH-5019; MPN RH-5019; LCSC C5199800

Connections:
+15V: C2.1, C3.1, D3.1 (K), Q1.3 (C), Q4.3 (C), R3.1, R8.1, R12.1, TP11.1
-15V: C4.2, C5.2, D4.2 (A), Q5.3 (C), R4.2, R6.2, R7.2, R9.2, R13.2, TP12.1
/+15V_IN: D3.2 (A), J6.1
/-15V_IN: D4.1 (K), J6.3
/IN+: J2.1 (In), J5.1, R2.1
/IN-: J1.1 (In), J4.1, R1.1, SW3.3, SW3.4
/OUT: J3.1 (In), J7.1, R10.1, R17.2, SW3.2, TP9.1
/Q1 B: D1.2 (A), D2.1 (K), Q1.1 (B), R1.2, TP1.1
/Q2 B: D1.1 (K), D2.2 (A), Q2.1 (B), R2.2, TP2.1
/Q2 C: Q2.3 (C), Q3.1 (B), R3.2, SW2.3, SW2.4, TP6.1
/Q3 C: C1.2, Q3.3 (C), Q4.1 (B), Q5.1 (B), R9.1, TP8.1
/TAIL: RV1.2, SW1.1, SW1.2, TP3.1
/X: R10.2, R11.1, SW3.1, TP10.1
GND: C2.2, C3.2, C4.1, C5.1, J1.2 (Ext), J2.2 (Ext), J3.2 (Ext), J4.2, J5.2, J6.2, J7.2, LED1.1 (K), LED2.2 (A), R5.1, R11.2, TP100.1, TP101.1, TP102.1, TP103.1
unnamed: C1.1, R14.2, SW2.2
unnamed: LED1.2 (A), R12.2
unnamed: LED2.1 (K), R13.1
unnamed: Q1.2 (E), RV1.3, TP13.1
unnamed: Q2.2 (E), RV1.1, TP14.1
unnamed: Q3.2 (E), R8.2, TP7.1
unnamed: Q4.2 (E), Q5.2 (E), R17.1
unnamed: Q6.1 (B), R5.2, R6.1, TP5.1
unnamed: Q6.3 (C), SW1.4
unnamed: Q6.2 (E), R7.1, TP4.1
unnamed: R4.1, SW1.3
unnamed: R14.1, SW2.1

Notes on the sheet:
stable either way. Both OFF: no compensation,
dead zone). As a follower it settles in 0.5 us with 55 deg of phase margin; the x11 amplifier
POWER
0.076 to 0.0004. Both OFF: no tail current, dead.
difference Q1 Q2, 1.5k collector load on the + side, tail from RV1 through SW1 x11
PROBING
unbalances the pair by up to +/-33 mV at the input:
has a bandwidth of 355 kHz and a gain of 10.1, 8 % low, as the book predicts for so little loop gain.
+15 V, GND, -15 V from a bench supply; 20 mA
The 1k is not in the book. A bare Miller cap feeds
non-inverting input
It costs half of stage 1's gain (11 instead of 20).
business'. With the 1k the follower has 55 deg of
OUTPUT (R17: not in the book)
-14 to +13 V into the 11k; +/-10 V into 1k.
1 ON: Q6, the 'simple sink' of Fig. 5L.10, 1.4 mA
does nothing instead of forward-biasing every
The sink raises the tail's impedance from 10k to
the signal FORWARD above 4 MHz, the loop's sign
OFFSET NULL (RV1: not in the book)
Open-loop gain at DC about 126 (the book says 'approximately 1000' for its CA3096 version, before the
emitter resistors, 25 ohm each at centre. Turning it
The two halves of the 50 ohm trimmer are the pair's
back to back between the bases: the bases never
phase margin and settles in 0.5 us; the x11 amp is
-15 V present
and Q4 / Q5 dissipate at most 127 mW (rated 200).
Normal: 1 ON, 2 OFF.
cancel the pair's Vbe mismatch in closed loop.
follower ring.
INPUTS
TAIL (SW1)
+15 V, GND, -15 V from a bench supply, 20 mA; +/-16 V max.
INPUT PROTECTION (R1, R2, D1, D2: not in the book)
PNP of Chapter 4 as six SOT-23 transistors, on a board whose silkscreen is this drawing.
2 ON: 10k to -15 V, 1.4 mA (Fig. 5L.1)
OFFSET NULL
to the IN- terminal, so R1 and the clamp still guard
TAIL -0.7 V Q2 C +13.8 V Q3 E +14.4 V Q3 C +0.5 V OUT -0.0 V tail 1.36 mA Q3 1.28 mA rails +/-14.8 V
A wire loop on every node named on the sheet;
about 1 M; stage 1's common-mode gain falls from
OUT
x11 divider in one: X = OUT / 11.
terminals: +/-14.8 V on the board. Everything
IN+
Quiescent as a follower with IN+ grounded (simulated with the 2N3904/2N3906 models, sim/opamp_sim.py):
the 1k; Ib (about 2 uA) drops 2 mV across it.
in the book's circuit is referred to those rails,
1 ON: 100 pF from Q3's collector to its base, Miller-
parallel; +/-12 V on either. For a common-mode
1k in series with each input, and two 1N4148
keeps a cable's capacitance on OUT from making the
ground loops for the scope's clip
1 ON: X to IN-, gain 11 (Fig. 5L.16)
Both OFF: nothing; wire your own network between
differ by more than 0.7 V, so no base-emitter
The book's bare push-pull reaches OUT through R17's
transistor. The rails run 0.17 V below the
A 1 M probe or a 50 ohm generator never notices
the clip.
The op-amp of Lab 5L (Learning the Art of Electronics, Hayes & Horowitz, 2016), built from the NPN and
and the x11 amplifier rings.
COMPENSATION (SW2)
DISCRETE TRANSISTOR OP-AMP
a scope hook grabs it. Four ground loops for
2 ON: OUT to IN-, a follower (Fig. 5L.18)
2 ON: the bare 100 pF, no 1k: the book's version.
FEEDBACK (SW3)
says the supply is on and the right way round.
330 ohm, inside the loop, which hides its drop. It is
low-pass at Q2 C. The book's Fig. 5L.17.
and nothing in it minds. A green LED per rail
M3 mounting holes, one per corner
test, tee one generator into both jacks.
follower Q4 Q5 push-pull, unbiased, so crossover distortion shows until feedback hides it x1
IN-
inverting input
gain Q3, PNP common emitter: 12k / (330 + re) = 32; the resting push-pull's dead zone leaves a third of it x11
junction sees its 6 V reverse breakdown when one
the OUT, IN- and GND terminals. The feedback goes
1 and 2 ON: the same as 2.
Three stages, as the book's Fig. 5L.11 and 5N.32:
the only protection: a short at the jacks draws 46 mA
enough to centre the output in open loop and to
+15 V present
Each input has a BNC and a screw terminal in
flips, and a follower oscillates: the book's 'risky
multiplied by the stage's gain of 30 into a 3 nF
Q1's base. The 10k + 1k are the book's load and its
Series Schottkys: a supply connected backwards
input is driven hard and the other is not.
Without it a short would put 1 W into Q5. It also

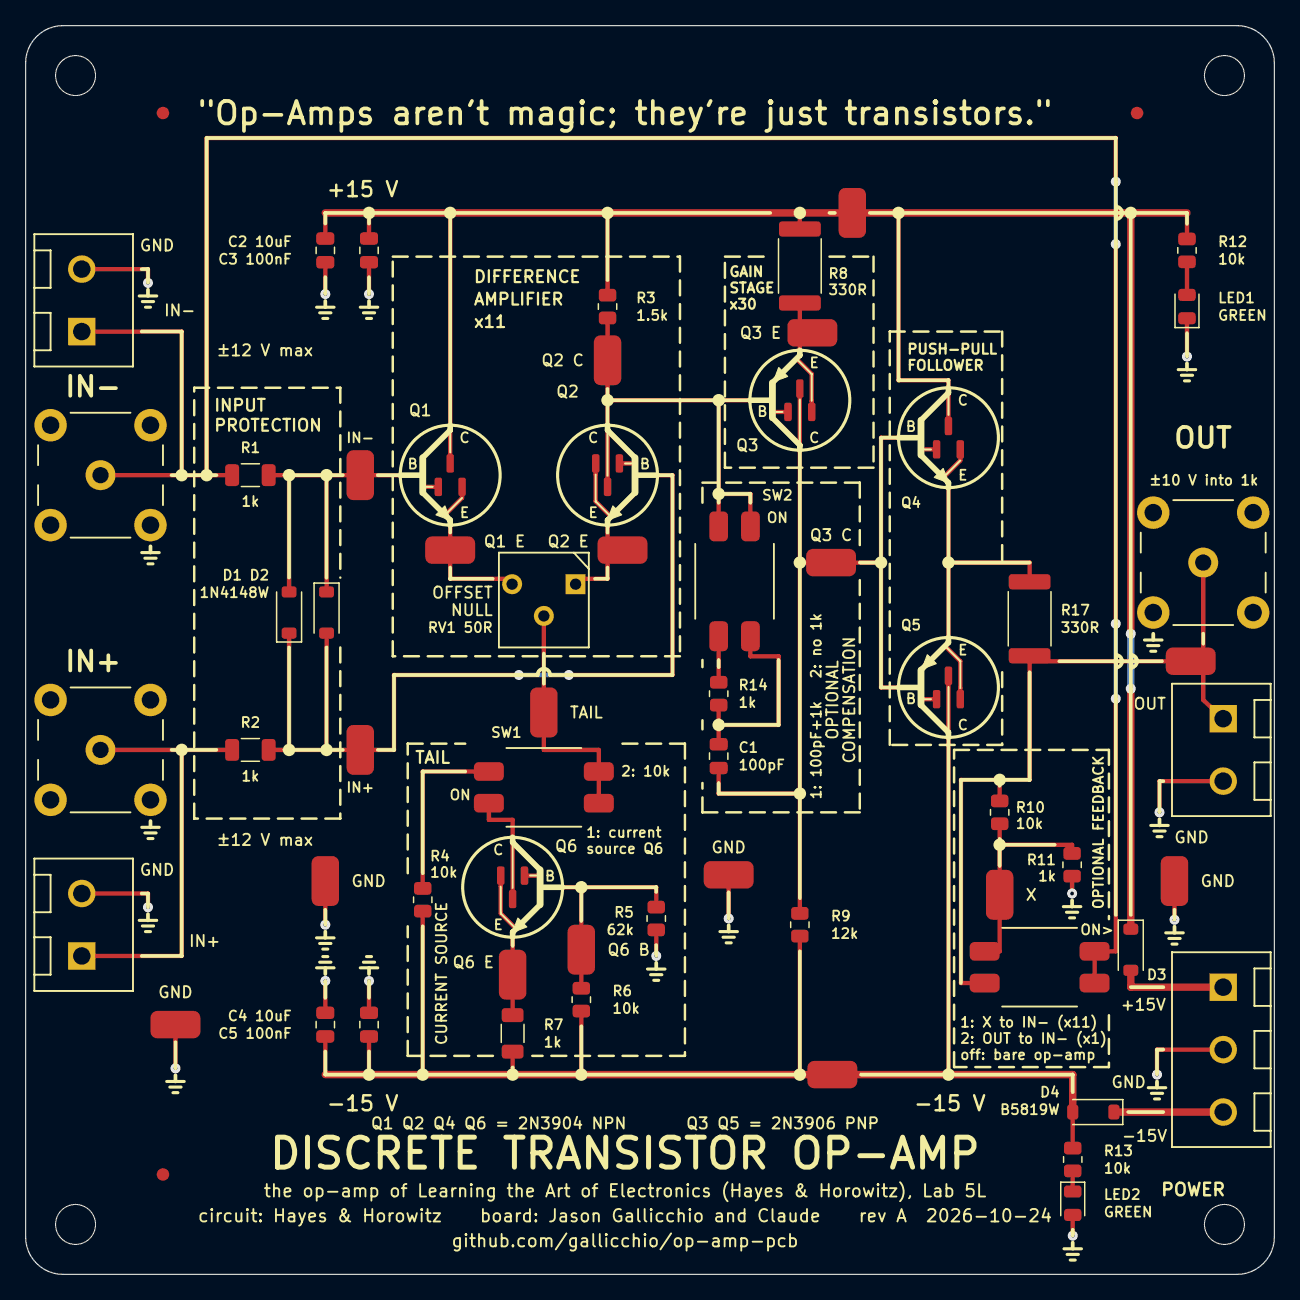
[picture p93: board opamp.kicad_pcb from above]

Board: 2 copper layers, 100.0 x 100.0 mm, 65 parts (0 on the bottom side), 26 nets.
