gallicchio/op-amp-pcb/(commit log)

2026-10-24 LAoE discrete op-amp board, rev A: generated schematic, PCB, fab package, docs
    The Lab 5L op-amp of Learning the Art of Electronics built from six SOT-23
    2N3904/2N3906 on a 100 x 100 mm two-layer board whose silkscreen is the
    schematic: copper follows the drawn wires, hops arc over crossings, every
    transistor sits in its symbol, dashed boxes name the stages, 17 probe loops.
    Three DIP switches select the tail (Q6 sink or 10k), the compensation
    (100 pF + 1k, or the book's bare 100 pF) and the feedback (x11, follower, or
    your own on the terminals); offset-null trimmer, input clamp, reverse-supply
    Schottkys, rail LEDs, BNCs and screw terminals.
    Everything is generated by make.py: footprints and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
    [opamp-B_Cu.gbr, opamp-B_Mask.gbr, opamp-B_Paste.gbr, opamp-B_Silkscreen.gbr, opamp-Edge_Cuts.gbr, opamp-F_Cu.gbr, opamp-F_Mask.gbr, opamp-F_Paste.gbr]
2026-10-24 Output current limit, textbook transistor symbols, labels where they belong
    Prompts 5-9: an OUTPUT CURRENT LIMIT box (R15, R16 47 ohm; Q7, Q8; D5, D6 --
    the diodes because the book's class-B pair would otherwise forward-bias the
    idle sense transistor and halve the swing), simulated at 22 mA into a short.
    Transistor symbols redrawn as the book draws them: bar, two legs, the arrow
    always on the emitter, B/C/E lettered, the package outline removed, each
    emitter wire brought out where the symbol's leg ends. Every switch explained
    in its own box; grounds all point down; lamps hang from the rails; ± signs;
    four ground loops; symmetric input loops; title without the acronym. Documents,
    handbook,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
    [opamp-B_Cu.gbr, opamp-B_Mask.gbr, opamp-B_Silkscreen.gbr, opamp-F_Cu.gbr, opamp-F_Mask.gbr, opamp-F_Paste.gbr, opamp-F_Silkscreen.gbr, opamp-PTH-drl_map.gbr]
2026-10-25 Bigger transistor symbols with hairlines to the pads; feedback box holds the divider; boxes clear of parts
    - Symbol round each SOT-23 redrawn at r 4 mm: bar, 45-degree legs turning vertical,
    arrow on the emitter, B C E inside, 0.16 mm hairline from each pad to its lead with
    the copper following; wires end where the leads leave the circle.
    - Right-hand third re-planned: the 10k/1k divider and its tap X (loop TP10 again)
    in the FEEDBACK box, SW3 turned inputs-left, the limiter's diode returns along the
    bands outside the boxes, OUT at y = 43 with the jack; no part on a box edge.
    - Labels measured against KiCad's stroke font; DRC silk rules satisfied (0.8 mm text,
    0.15 mm clearance). R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
    [opamp-B_Cu.gbr, opamp-B_Mask.gbr, opamp-B_Silkscreen.gbr, opamp-F_Cu.gbr, opamp-F_Mask.gbr, opamp-F_Paste.gbr, opamp-F_Silkscreen.gbr, opamp-PTH-drl_map.gbr]
2026-10-25 Design review round 1: the brief, the reviewers' directory convention, and the author's own review with a tested patch
    design_reviews/DESIGN_REVIEW_PROMPT.md is the brief for other LLMs: each reviewer
    works only in design_reviews/<date>_<model>/, copies the project into its gitignored
    project/ to build, and writes REPORT.md there. design_reviews/README.md indexes the
    rounds.
    design_reviews/2026-10-24_Claude-Fable-5.1/ is the author's review, done before
    reading any other: eleven findings, the main ones that COMPENSATION 2 alone is an
    open circuit rather than the bare 100 pF the board and documents describe, that a
    short to a rail puts 0.43 W into a SOT-23 the stocked part rates at 0.2 W, a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
2026-10-25 Apply the round-1 review: COMPENSATION 2 is the bare 100 pF, ON marks, the 50 mA rule, honest output numbers
    The author's own design review (design_reviews/2026-10-24_Claude-Fable-5.1) found
    that the COMPENSATION switch's position 2 on its own was an open circuit, not the
    book's bare 100 pF the board and documents described; pole 2 now runs from Q2 C
    straight to the R14 / C1 junction on the sheet and the board. Each DIP switch
    carries an ON mark on the side its footprint says, and the preview check compares
    the part's own marking with it. The back of the board and the handbook make the
    bench supply's 50 mA limit the rule (a ground clip on Q2 C or Q3 E would otherwise
    put 0.6 W into R8), sa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
    [opamp.kicad_pcb, opamp.kicad_sch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]
2026-10-25 The motto on the front, above the +15 V rail: Op-Amps aren't magic, they're just transistors.
    Claude-Session: https://claude.ai/code/session_0175L9dWhBszPLisfG6QV6ET
    [opamp.kicad_pcb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]
2026-10-25 The motto's comma splice becomes a semicolon
    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
    [opamp.kicad_pcb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]
2026-10-25 LED2 beside POWER, OPTIONAL COMPENSATION and OPTIONAL FEEDBACK, the back's instructions one idea per line with the https URL
    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
    [opamp-B_Cu.gbr, opamp-B_Silkscreen.gbr, opamp-F_Cu.gbr, opamp-F_Mask.gbr, opamp-F_Paste.gbr, opamp-F_Silkscreen.gbr, opamp-PTH-drl_map.gbr, opamp-PTH.drl]
2026-10-28 Apply design review round 1 (Gemini 4 Argon, Kimi K3): R17 isolates the OUT jacks, R8 2512 and R7 1206 survive ground clips, terminals turned for JLCPCB, placement checks fixed, Schottkys in the simu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
    R17 (47 ohm) feeds both OUT jacks from the loop's node with the feedback taken before
    it: 100 pF of coax made the simulated follower oscillate at 13 MHz once the output left
    the push-pull's dead band. R8 is a 1 W 2512 and R7 a 1206 so a scope's ground clip on
    Q3 E, Q2 C, Q6 E or Q6 B burns nothing. KF301 CPL rotation +180 and footprint body
    flipped to the vendor drawing. PLACEMENT_CHECKS lists every part's own line. The
    simulation includes D3/D4, the bypass caps, R14 and R17; numbers r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
    [opamp-B_Cu.gbr, opamp-B_Mask.gbr, opamp-B_Silkscreen.gbr, opamp-F_Cu.gbr, opamp-F_Mask.gbr, opamp-F_Paste.gbr, opamp-F_Silkscreen.gbr, opamp-PTH-drl_map.gbr]
2026-10-28 Output protection is R17 alone: 330 ohm inside the loop replaces the 741-style limiter (Q7, Q8, R15, R16, D5, D6), so the output stage is the book's bare push-pull; feedback taken at the jacks; schem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
    [opamp-B_Cu.gbr, opamp-B_Mask.gbr, opamp-B_Silkscreen.gbr, opamp-F_Cu.gbr, opamp-F_Mask.gbr, opamp-F_Paste.gbr, opamp-F_Silkscreen.gbr, opamp-PTH-drl_map.gbr]
2026-10-30 Pre-order checks from the new CLAUDE_PCB.md lessons: JLCPCB's drawings fitted, overlaid by the upload CPL and pin-named (all pass, now in the build); assembly drawings fitted to Letter; schematic tit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
    - scripts/check_rotations.py, check_pinouts.py (from AMOD-and-RFMOD) and
    check_overlay.py (new): 21 codes fit the table, 61 placements land on their pads,
    connectors face off the board, transistor pins B E C on 1 2 3
    - scripts/fit_pdf.py (CostasLink's, with --from-scale and reproducible output):
    the assembly drawings were 1:1 in the corner of A4 with the left jacks off the page
    - check_outputs.py: Letter fill and no schematic text past t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
    [opamp.kicad_sch]
2026-10-30 Rev A preview read: every CPL rotation confirmed; RV1's nudge traced to its footprint (the 3362P's body is not centred on its pins), now caught by check_overlay.py's body check; footprint fix on the 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
    - parts.JLC_ROTATION: all twelve entries read in the rev A preview (2026-10-29)
    - check_overlay.py: the centre of JLCPCB's whole drawing against our courtyard's
    (0.5 mm); RV1 at 1.33 mm is the one known exception, harmless on rev A
    - DESIGN_NOTES 5.9 and the rev B list; PLACEMENT_CHECKS and MANUFACTURING regenerated
    - board, gerbers and CPL unchanged
    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
